sjaga003/CovidCube/README.md

# Covid Puzzle Cube

<p align="center">
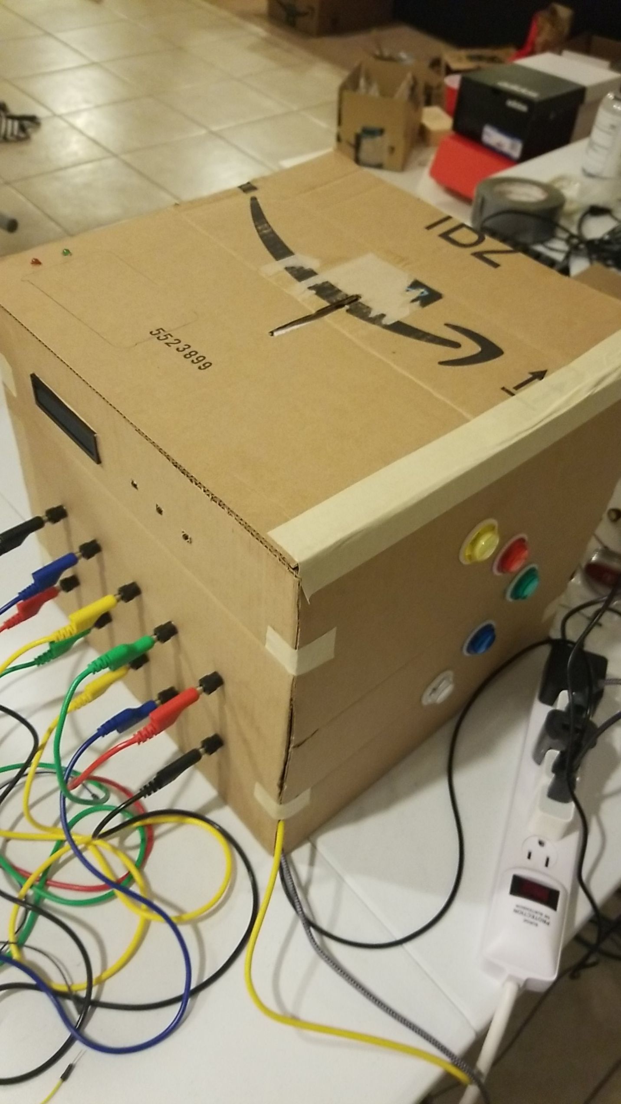
[picture p1: Resources/CovidCubeHeader.jpg]
  
</p>

The Covid Puzzle Cube is an educational and fun puzzle box that serves to teach the user about quarantine etiquette. View the live demonstration of the cube [here](https://www.youtube.com/watch?v=G0hbTkjBLCU)!

## Overview

This project was designed over the course of 8 weeks and built in 2 weeks as part of CS179J: Embedded Systems Senior Design, with a team of 5 members at UC Riverside. The Covid Puzzle Cube has 5 puzzles that all interact with each other and share data with a corresponding mobile app. The **full final report** is viewable [here](Resources/Final_Report.pdf) with **in depth design and testing information**. This project was written using a combination of Python and CSS, the card dispenser was 3D printed.

## Flowcharts & Diagrams

<p align="center">
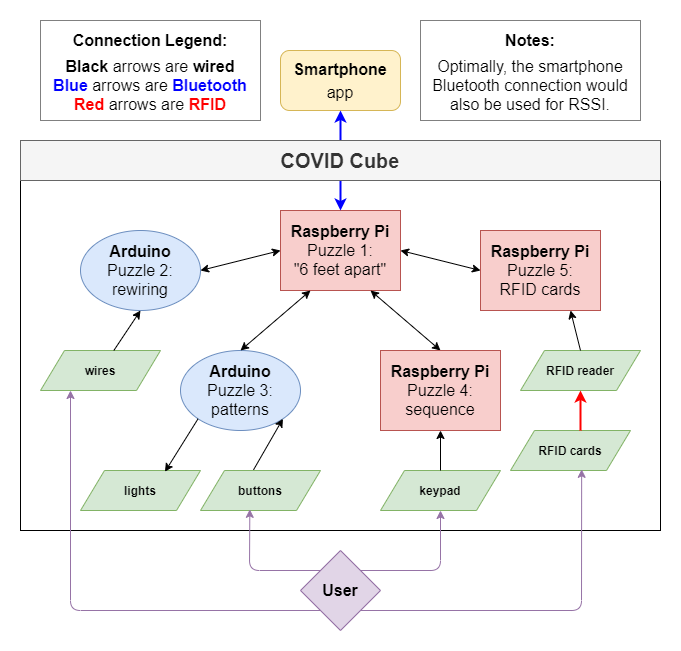
[picture p2: Resources/systemdiagram.png]
  
  <div>A system diagram of how all the devices are laid. Also includes each subsystems input and output signals.</div>
  <br>
  <br>
</p>

<p align="center">
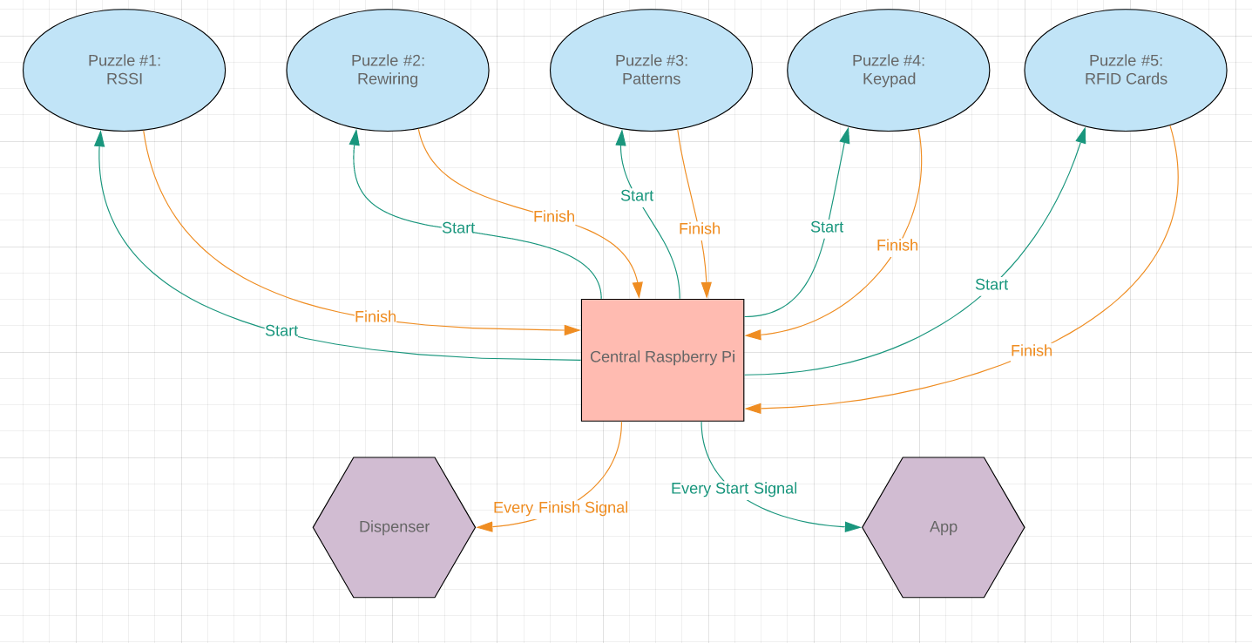
[picture p3: Resources/centraldiagram.png]
  
  <div>A diagram describing how signals will be sent from each subsystem.</div>
  <br>
  <br>
</p>

<p align="center">
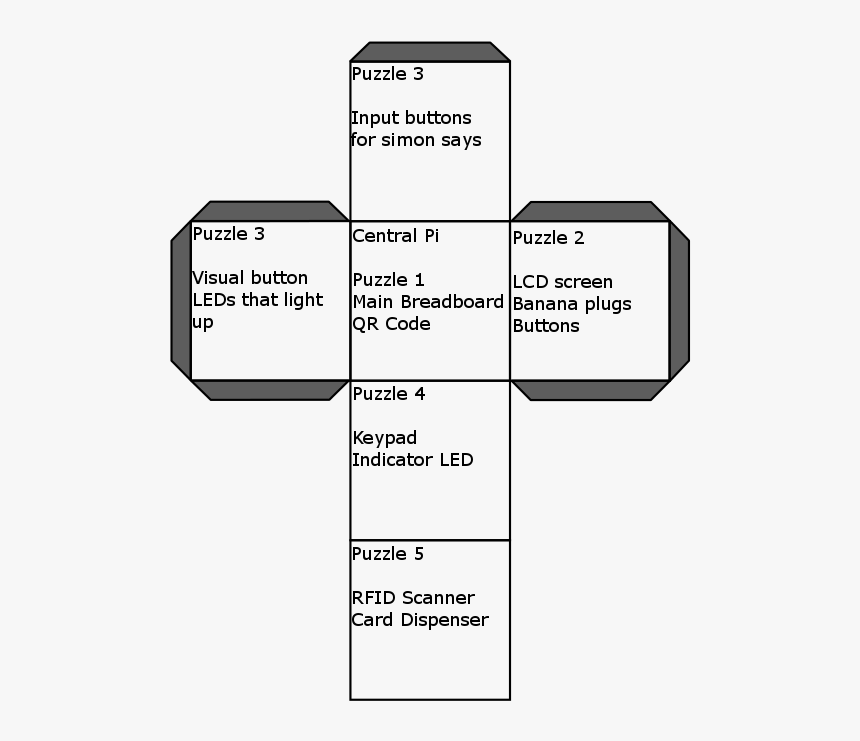
[picture p4: Resources/physicaldiagram.png]
  
  <div>Physical diagram describing how the box will physically be laid out.</div>
  <br>
  <br>
</p>

<p align="center">
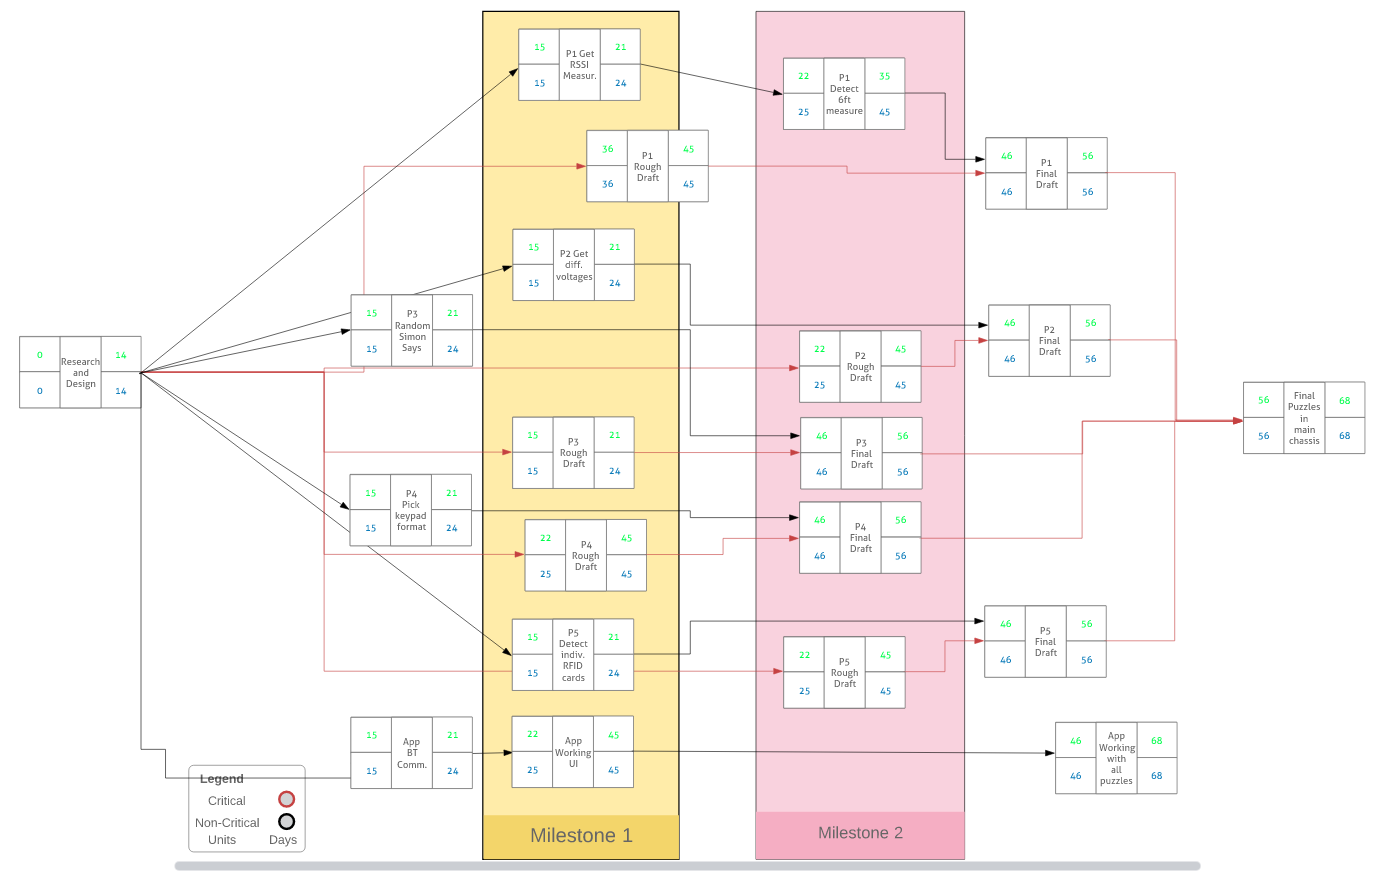
[picture p5: Resources/gantt.png]
  
  <div>Gantt Chart describing how long each subsystem would take to complete and test.</div>
  <br>
  <br>
</p>

## Future Developments

If we are to continue development on this project we would like to clean up the exterior with 3D printed exterior parts, and to give the cube a portable power source so it is more easily movable.
