sjaga003/CovidCube/Resources/start_qr.png

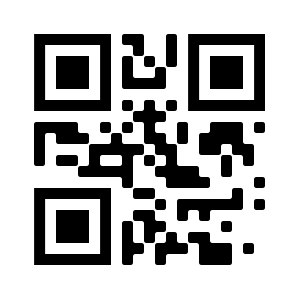
Resources/start_qr.png
