sjaga003/CovidCube/Puzzle 3/motor tray test.obj

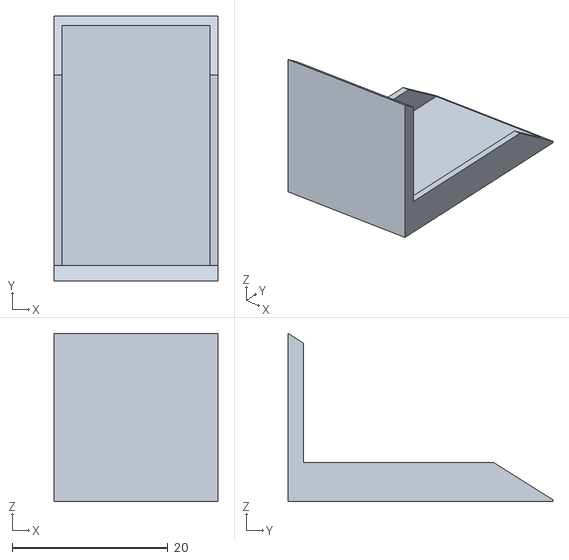
[picture p23: CAD file, 2020-08-30]
Puzzle 3/motor tray test.obj
21.0 x 34.0 x 21.6
