sjaga003/CovidCube/Puzzle 5/RFidGUI.py

from gpiozero import LED, Buzzer
from guizero import App, Box, Text, TextBox, warn
import csv

led8 = LED(19)

def clearDisplay():
    print("Clear display")
    rfidStatus.value = "---"
    rfidText.value = ""
    led8.off()
    rfidStatus.repeat(1000,checkRFidTag)
    
def checkRFidTag():
    tagId = rfidText.value
    if tagId != "":
        RFidRegistered = False
        print(tagId)
        with open("Database.csv") as csvfile:
            reader = csv.DictReader(csvfile)
            for row in reader:
                if row["RFid"] == tagId:
                    RFidRegistered = True
                    print("Welcome " + row["User"])
                    rfidStatus.value = "Welcome " + row["User"]
                    fl = open("ID.txt","w")
                    fl.write(row["User"])
                    fl.close()
                    led8.on()
                    rfidStatus.after(1000, clearDisplay)
                    
        if RFidRegistered == False:
            print("RFid tag is not registered")
            rfidStatus.value = "RFid tag is not registered"
            rfidStatus.after(1000, clearDisplay)
            
        rfidStatus.cancel(checkRFidTag)
        
app = App(title="RFID Simple Gui", width=350, height=150, layout="auto")


rfidText = TextBox(app)
rfidStatus = Text(app, text="---")
rfidStatus.repeat(1000, checkRFidTag) 

app.display()
        
