sjaga003/CovidCube/(commit log)

2020-07-23 first commit, testing the motor and randomizing the puzzle
2020-08-05 Final draft for puzzle
    [motor tray test.obj]
2020-08-25 Puzzle 1 integrated into app flow
2020-08-27 servo code
    Code for the servo Arduino since we moved it from puzzle 3
2020-08-30 Adding puzzle 5 files
    [Database.csv]
2020-08-31 Final version of Puzzle 2
    Fully integrated wire matching, sequence matching, and start/finish signals
2020-08-31 Potentiometer Testbench
    Reads analog voltage and displays to serial monitor -- used to calibrate potentiometers for wire matching
2020-08-31 Puzzle 2 -- Wire matching
    Used as a regression test to ensure wire-matching hardware works properly without other parts of puzzle 2 interfering
    [WireMatching.ino]
2021-01-24 Cleanup file structure
    [Database.csv, motor tray test.obj]
